Matt-Santos/PWM-Motor-Driver/documents/README.md

This project focuses on designing and evaluating a brushless motor control circuit that implements both Sinusoidal Pulse Width Modulation (SPWM) and Trapezoidal Pulse Width Modulation (TPWM) techniques, without the use of positional feedback. The circuit integrates several subcircuits, including a Wien Bridge Oscillator, Triangle Wave Generator, Three Phase Generator, Comparator, Modulation/Inversion Circuit, and H-Bridge Driver. During testing, issues such as Wien Bridge instability, phase shift deviations, and back-emf voltage from motor rotation were observed. Despite these challenges, both SPWM and TPWM successfully actuated the motor within a 5Hz to 95Hz frequency range, with SPWM providing smoother performance compared to the more erratic TPWM.
