Matt-Santos/PWM-Motor-Driver/documents/images/Circuit Pictures/20160403_171216.jpg

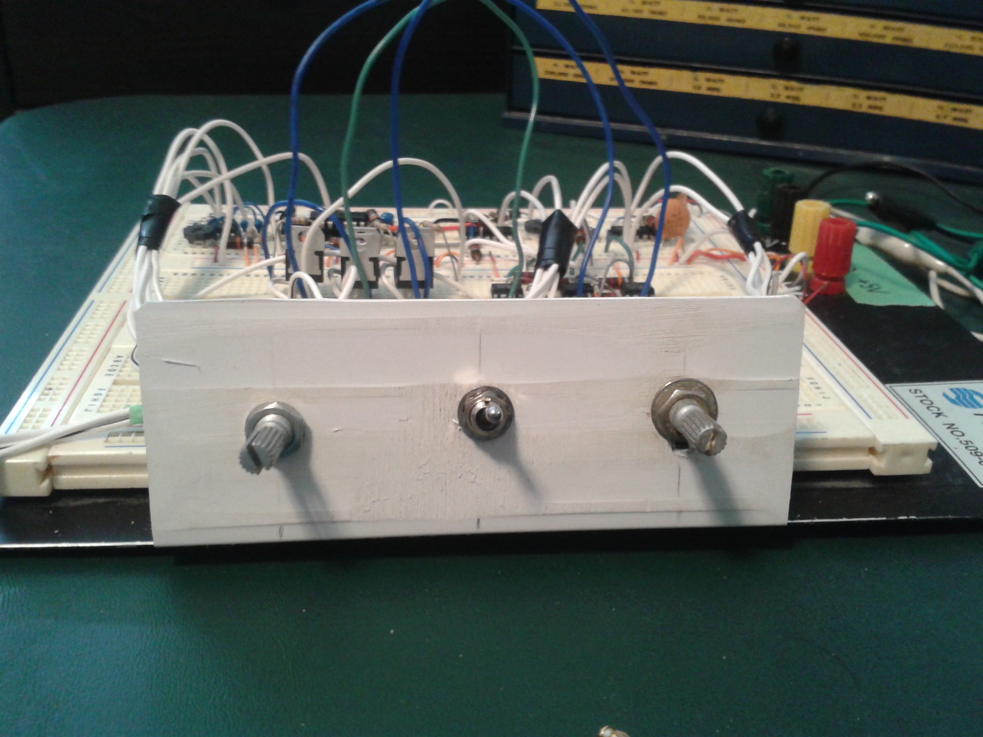
documents/images/Circuit Pictures/20160403_171216.jpg
