Matt-Santos/PWM-Motor-Driver/documents/images/Circuit Pictures/Final Budget.png

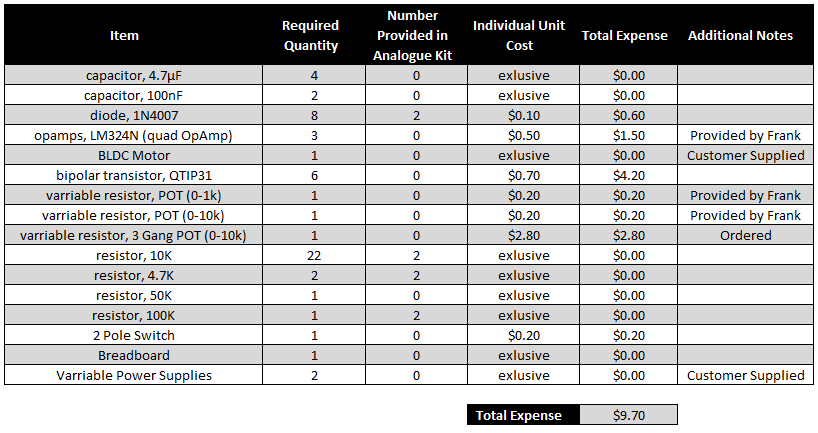
documents/images/Circuit Pictures/Final Budget.png
