Matt-Santos/PWM-Motor-Driver/documents/images/Circuit Pictures/Wien Bridge Oscillator.png

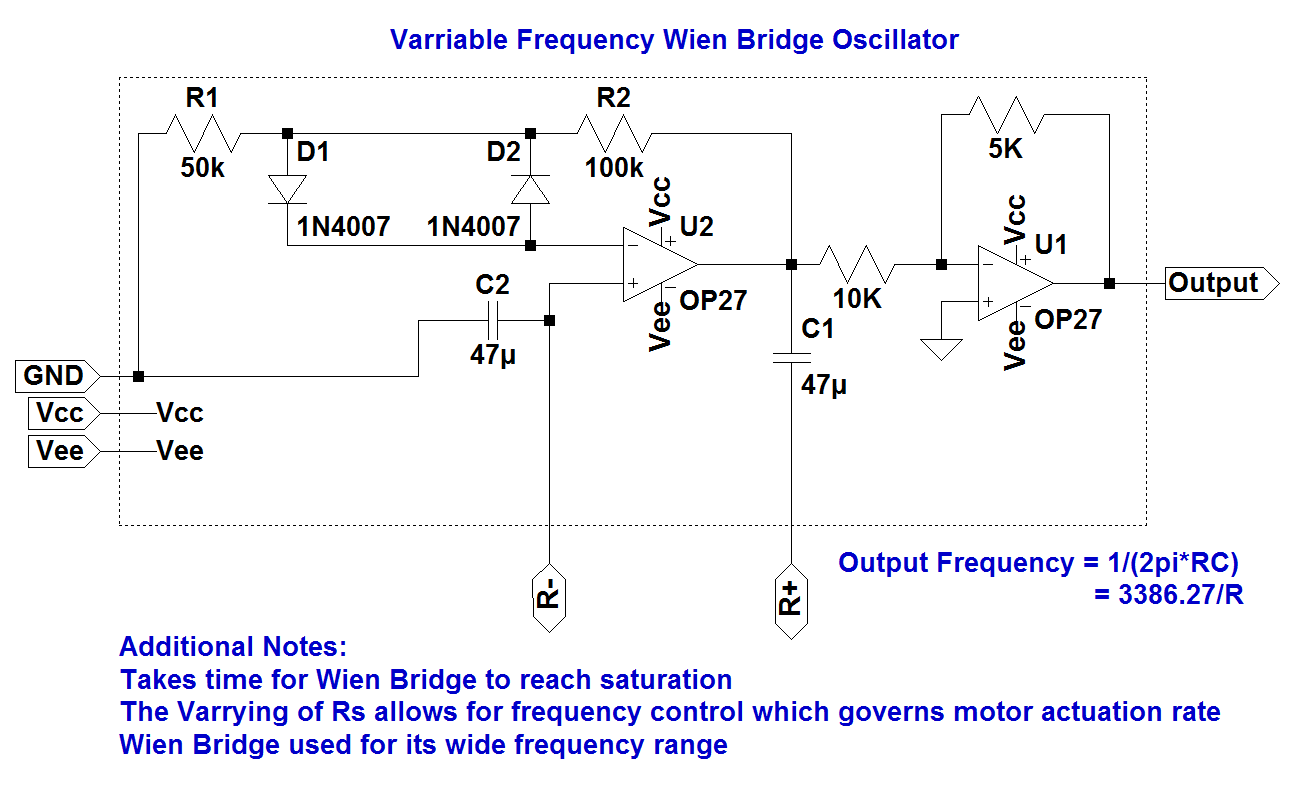
documents/images/Circuit Pictures/Wien Bridge Oscillator.png
