Matt-Santos/PWM-Motor-Driver/documents/images/Data Analysis/SPWM_Inversion.png

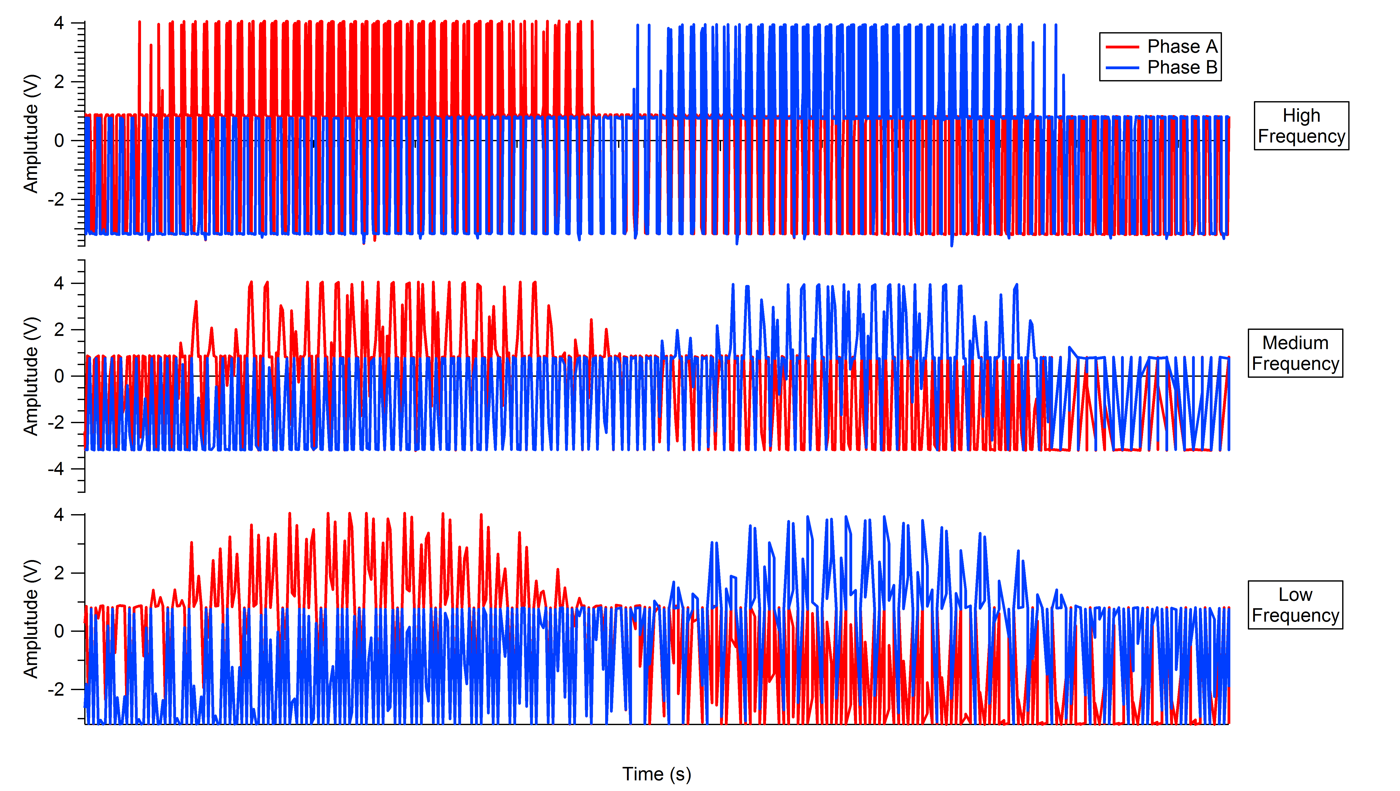
documents/images/Data Analysis/SPWM_Inversion.png
