Matt-Santos/PWM-Motor-Driver/documents/images/gallery/DC_Block_Diagram.jpg

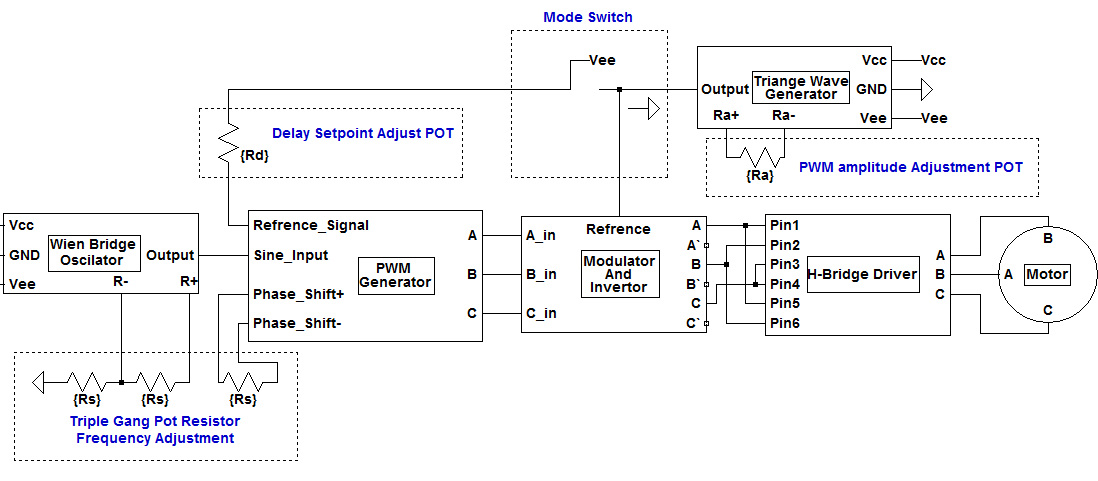
documents/images/gallery/DC_Block_Diagram.jpg
