Matt-Santos/PWM-Motor-Driver/documents/images/gallery/Overall_Design.jpg

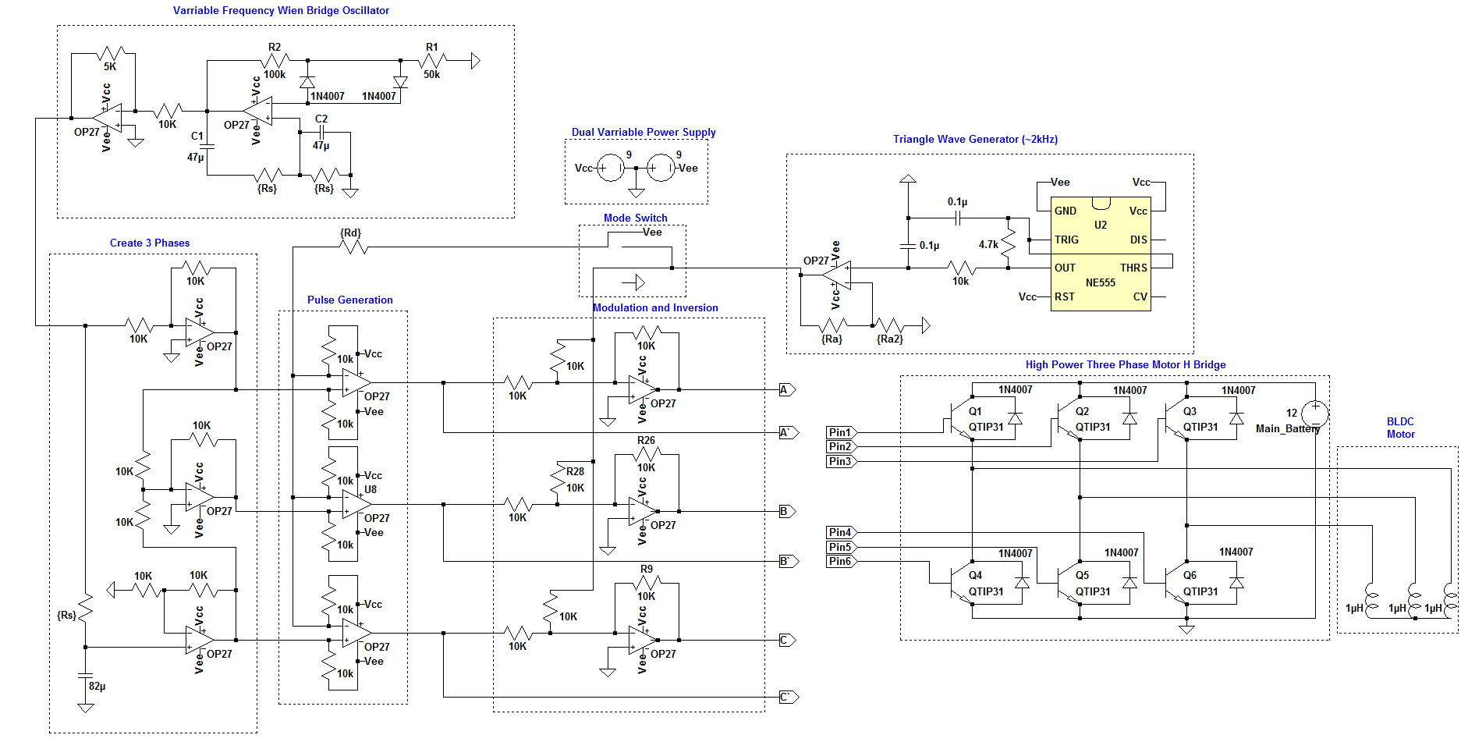
documents/images/gallery/Overall_Design.jpg
