Matt-Santos/PWM-Motor-Driver/documents/images/gallery/WBOFIXED.jpg

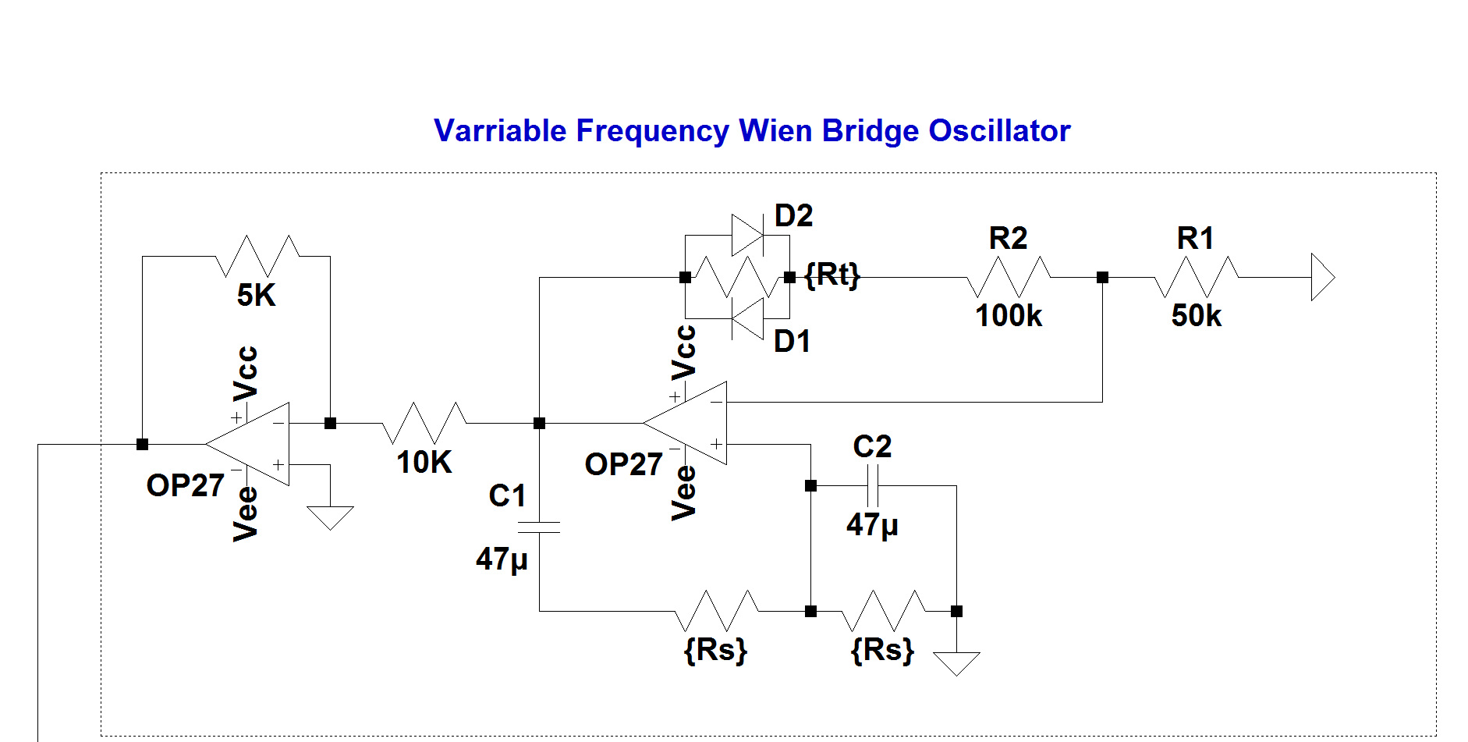
documents/images/gallery/WBOFIXED.jpg
