Matt-Santos/PWM-Motor-Driver/documents/images/project.jpg

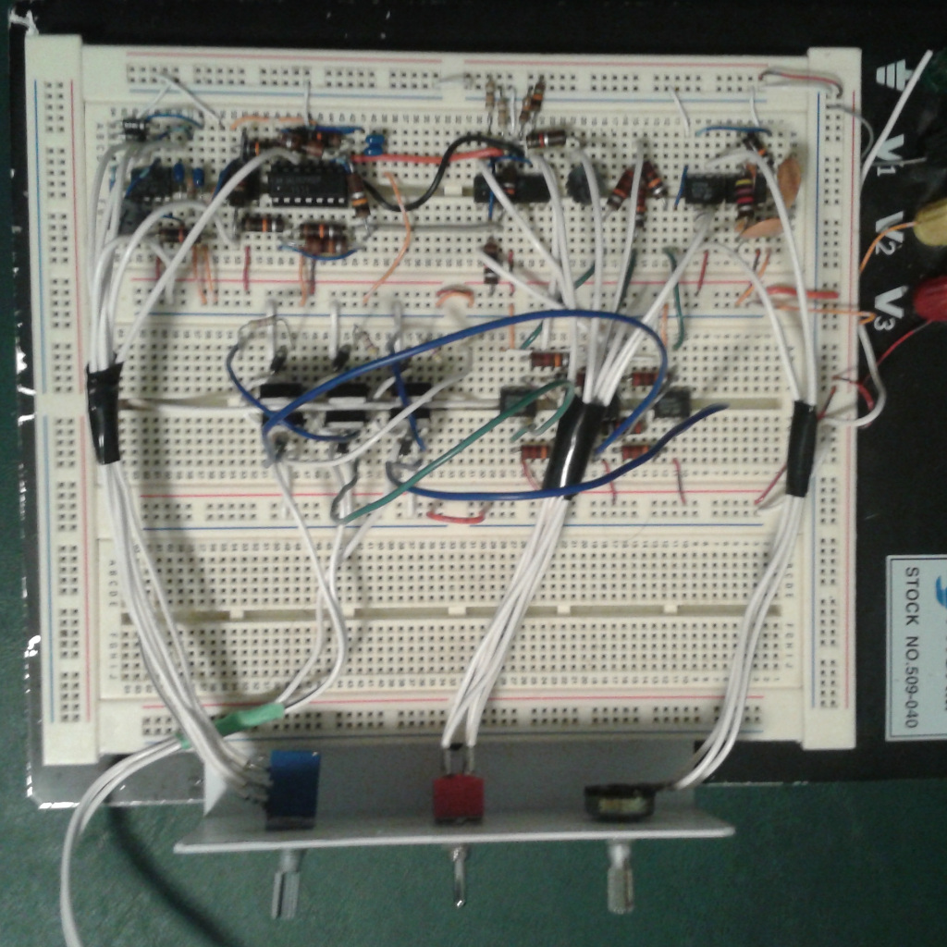
documents/images/project.jpg
