Matt-Santos/PWM-Motor-Driver/documents/Misc Data/h-bridge_thumb.png

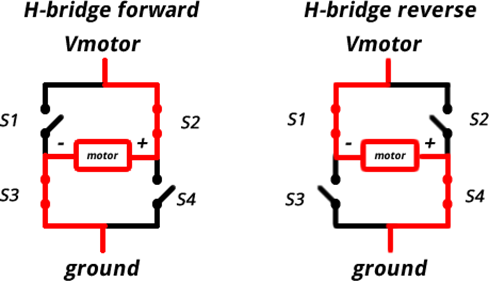
documents/Misc Data/h-bridge_thumb.png
