Matt-Santos/PWM-Motor-Driver/documents/Misc Data/PWM_Waveform2_Kurtis.png

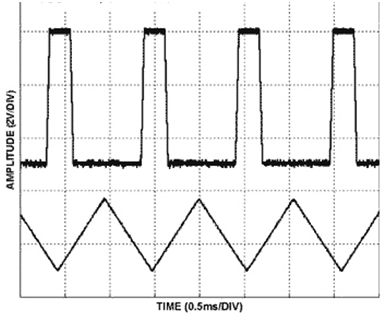
documents/Misc Data/PWM_Waveform2_Kurtis.png
