Matt-Santos/PWM-Motor-Driver/documents/Misc Data/PWM_Waveform3_Kurtis.png

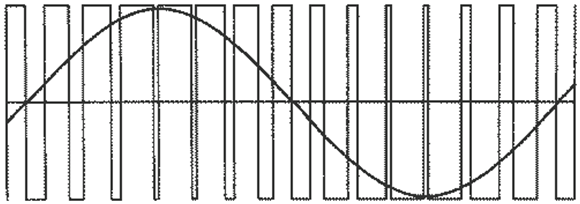
documents/Misc Data/PWM_Waveform3_Kurtis.png
