Matt-Santos/PWM-Motor-Driver/documents/Misc Data/Two Phase Motor States.jpg

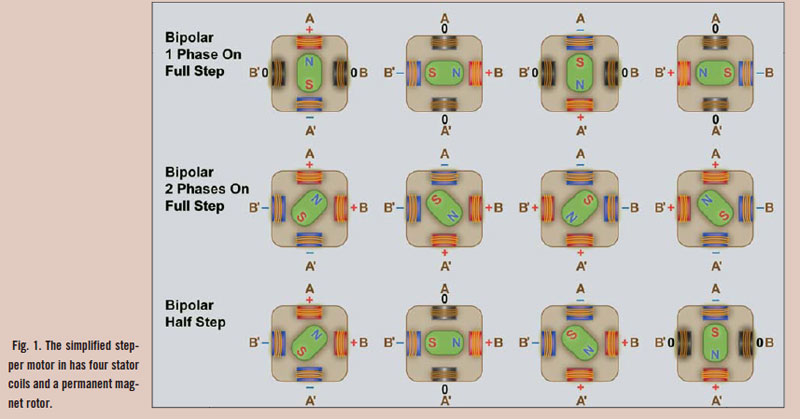
documents/Misc Data/Two Phase Motor States.jpg
