Matt-Santos/PWM-Motor-Driver/documents/Refrences/Design.bmp

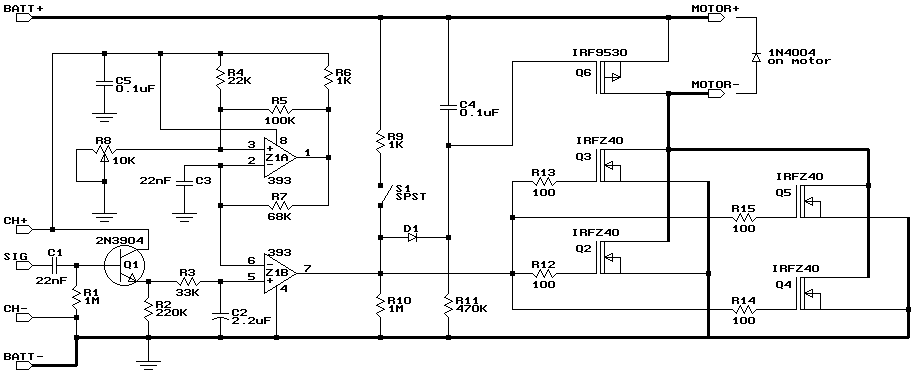
documents/Refrences/Design.bmp
