Matt-Santos/PWM-Motor-Driver/documents/Bill of Materials.xlsx

Sheet: Sheet1
Circuit Compatibility Check | Item | Quantity | Cost Per Unit | Total Cost | Number in Kit | Number in Stock | Location | Notes
 | 9V Battery | 2 | 1.31 | 2.62 | 0 | alot | somewhere
Good | NE555 | 1 | Free | 0 | 1 | 3 | Kurtus has
 | BLDC Motor | 1 | Free | 0 | 0 | 1 | my desk
Good | Breadboard | 1 | Free | 0 | 0 | 3 | shelf
 | 5-15V high current battery | 1 | Free | 0 | 0 | ?
 | 1N4007 Diode | 2 | Free | 0 | 2 | 2 | Analogue Kit
 | OP27 OpAmp | 2 | Free | 0 | 2 | 2 | Kit + Need
 | Power Transistors | 6 | ? |  | 0 | alot | shelf | alot of old ones on the shelf (15A)
 | 10k Resistors | 17 | 0.08 | 1.36
 | 100k | 2 | 0.08 | 0.16
 | 50k | 3 | 0.08 | 0.24
 | Varriable Resistors
 | Arguements |  |  |  |  |  | Total Cost | 4.38
 | Motor is application does not cost
 | Batteries not included (12V Driver)

Sheet: Sheet2
--- Bill of Materials --- |  |  | Overall Design
Ref. | Mfg. | Part No. | Description
R1 | -- | -- | resistor, 5.6K
R2 | -- | -- | resistor, 50K
R3 | -- | -- | resistor, 50K
R4 | -- | -- | resistor, 1K
R5 | -- | -- | resistor, 1K
--- Bill of Materials --- |  |  | Triangle Wave
Ref. | Mfg. | Part No. | Description
C1 | -- | -- | capacitor, 100nF
C2 | -- | -- | capacitor, 200nF
R1 | -- | -- | resistor, 100K
R2 | -- | -- | resistor, 10K
R3 | -- | -- | resistor, 50K
R4 | -- | -- | resistor, 10K
U1 | (unknown) | NE555 | (unknown 3rd party model)
U2 | (unknown) | OP27 | (unknown 3rd party model)
--- Bill of Materials --- |  |  | Wien Bridge
Ref. | Mfg. | Part No. | Description
C1 | -- | -- | capacitor, 47µF
C2 | -- | -- | capacitor, 47µF
D1 | -- | 1N4007 | diode
D2 | -- | 1N4007 | diode
R1 | -- | -- | resistor, 50K
R2 | -- | -- | resistor, 100K
U2 | (unknown) | OP27 | (unknown 3rd party model)
--- Bill of Materials --- |  |  | PWM Generator
Ref. | Mfg. | Part No. | Description
C2 | -- | -- | capacitor, 1µF
R1 | -- | -- | resistor, 10K
R2 | -- | -- | resistor, 10K
R3 | -- | -- | resistor, 10K
R4 | -- | -- | resistor, 10K
R5 | -- | -- | resistor, 10K
R6 | -- | -- | resistor, 10K
R7 | -- | -- | resistor, 10K
R10 | -- | -- | resistor, 10K
R11 | -- | -- | resistor, 10K
R12 | -- | -- | resistor, 10K
R22 | -- | -- | resistor, 10K
R23 | -- | -- | resistor, 10K
R26 | -- | -- | resistor, 10K
R28 | -- | -- | resistor, 10K
R29 | -- | -- | resistor, 10K
U1 | (unknown) | OP27 | (unknown 3rd party model)
U2 | (unknown) | OP27 | (unknown 3rd party model)
U3 | (unknown) | OP27 | (unknown 3rd party model)
U4 | (unknown) | OP27 | (unknown 3rd party model)
U8 | (unknown) | OP27 | (unknown 3rd party model)
U9 | (unknown) | OP27 | (unknown 3rd party model)
U10 | (unknown) | OP27 | (unknown 3rd party model)
--- Bill of Materials --- |  |  | Motor Driver
Ref. | Mfg. | Part No. | Description
M1 | -- | NMOS | MOSFET
M2 | -- | NMOS | MOSFET
M3 | -- | NMOS | MOSFET
M4 | -- | NMOS | MOSFET
M5 | -- | NMOS | MOSFET
M6 | -- | NMOS | MOSFET

Sheet: Kit Contents
Item | Quantity
4007 | 2
OP27GP | 2
1N4003 | 2
1N4733A | 2
2N3906 | 2
334-103 | 1
IR50 | 2
4.7R25 | 2
10R16 | 2
47R16 | 2
LED-5R | 2
91AR-20K | 1
ZVN2110A | 2
ZVP2110A | 2
R1/4-10 | 2
R1/4-100 | 2
R1/4-470 | 2
R1/4-1K | 2
R1/4-2.2K | 2
R1/4-4.7K | 2
R1/4-10K | 2
R1/4-22K | 2
R1/4-47K | 2
R1/4-100K | 2
R1/4-220K | 2
R1/4-1M | 2

Sheet: Sheet3
--- Bill of Materials ---
Ref. | Mfg. | Part No. | Description
C1 | -- | -- | capacitor, 47µF
C2 | -- | -- | capacitor, 47µF
C3 | -- | -- | capacitor, 100nF
C4 | -- | -- | capacitor, 100nF
C5 | -- | -- | capacitor, 82µF
D1 | -- | 1N4007 | diode
D2 | -- | 1N4007 | diode
D3 | -- | 1N4007 | diode
D4 | -- | 1N4007 | diode
D5 | -- | 1N4007 | diode
D6 | -- | 1N4007 | diode
D7 | -- | 1N4007 | diode
D8 | -- | 1N4007 | diode
Q1 | -- | QTIP31 | bipolar transistor
Q2 | -- | QTIP31 | bipolar transistor
Q3 | -- | QTIP31 | bipolar transistor
Q4 | -- | QTIP31 | bipolar transistor
Q5 | -- | QTIP31 | bipolar transistor
Q6 | -- | QTIP31 | bipolar transistor
R1 | -- | -- | resistor, 50K
R2 | -- | -- | resistor, 100K
R3 | -- | -- | resistor, 0 |  |  |  |  | corrected price
R4 | -- | -- | resistor, 0 | 1 3 gang pot |  | $2.50 |  | $2.50
R5 | -- | -- | resistor, 0 | 2 10k pots |  | $1.50 |  | $1.50
R6 | -- | -- | resistor, 0 | 6 QTIP31 transistors |  | $3.00 |  | $3.00
R7 | -- | -- | resistor, 10K | 8 1N4007 Diodes |  | $0.80 | 8@10c | $0.60
R8 | -- | -- | resistor, 4.7K | 12 Op27 | use quand LM324N | $1.50 | 3@50c | $1.50
R9 | -- | -- | resistor, 10K | 1 2 pole toggle switch |  | $0.20 |  | $0.20
R10 | -- | -- | resistor, 0 |  | total | $9.50 |  | $9.30
R11 | -- | -- | resistor, 10K
R12 | -- | -- | resistor, 10K
R13 | -- | -- | resistor, 10K
R14 | -- | -- | resistor, 10K
R15 | -- | -- | resistor, 10K
R16 | -- | -- | resistor, 10K
R17 | -- | -- | resistor, 10K
R18 | -- | -- | resistor, 10K
R19 | -- | -- | resistor, 10K
R20 | -- | -- | resistor, 10K
R21 | -- | -- | resistor, 10K
R22 | -- | -- | resistor, 10K
R23 | -- | -- | resistor, 10K
R24 | -- | -- | resistor, 10K
R25 | -- | -- | resistor, 5K
R26 | -- | -- | resistor, 10K
R27 | -- | -- | resistor, 10K
R28 | -- | -- | resistor, 10K
R29 | -- | -- | resistor, 10K
R30 | -- | -- | resistor, 10K
R31 | -- | -- | resistor, 10K
R32 | -- | -- | resistor, 10K
R33 | -- | -- | resistor, 10K
R34 | -- | -- | resistor, 10K
R35 | -- | -- | resistor, 10K
R36 | -- | -- | resistor, 10K
R37 | -- | -- | resistor, 10K
U1 | (unknown) | OP27 | (unknown 3rd party model)
U2 | (unknown) | NE555 | (unknown 3rd party model)
U3 | (unknown) | OP27 | (unknown 3rd party model)
U4 | (unknown) | OP27 | (unknown 3rd party model)
U5 | (unknown) | OP27 | (unknown 3rd party model)
U6 | (unknown) | OP27 | (unknown 3rd party model)
U7 | (unknown) | OP27 | (unknown 3rd party model)
U8 | (unknown) | OP27 | (unknown 3rd party model)
U9 | (unknown) | OP27 | (unknown 3rd party model)
U10 | (unknown) | OP27 | (unknown 3rd party model)
U11 | (unknown) | OP27 | (unknown 3rd party model)
U12 | (unknown) | OP27 | (unknown 3rd party model)
U13 | (unknown) | OP27 | (unknown 3rd party model)

Sheet: Sheet4
Ref. | Mfg. | Part No. | Description
C1 | -- | -- | capacitor, 47µF | Item | Required Quantity | Number Provided in Analogue Kit | Number in Inventory | Estimated Unit Cost | Total Expense | Additional Notes
C2 | -- | -- | capacitor, 47µF | capacitor, 47µF | 2 | 0 | 3 | exlusive | $0.00
C3 | -- | -- | capacitor, 100nF | capacitor, 100nF | 2 | 0 | 10 | exlusive | $0.00
C4 | -- | -- | capacitor, 100nF | capacitor, 82µF | 2 | 0 | 0 | exlusive | $0.00 | Need to Order
C5 | -- | -- | capacitor, 82µF | diode, 1N4007 | 8 | 2 | 100+ | $0.10 | $0.60
D1 | -- | 1N4007 | diode | opamps, LM324N (quad OpAmp) | 3 | 0 | unknown | $0.50 | $1.50 | alternatives exist
D2 | -- | 1N4007 | diode | BLDC Motor | 1 | 0 | 1 | exlusive | $0.00 | Customer Supplied
D3 | -- | 1N4007 | diode | bipolar transistor, QTIP31 | 6 | 0 | 40+ | $0.50 | $3.00
D4 | -- | 1N4007 | diode | varriable resistor, POT (0-10k) | 1 | 0 | 0 | $0.75 | $0.75 | Need to Order
D5 | -- | 1N4007 | diode | varriable resistor, POT (0-10k) | 1 | 0 | 0 | $0.75 | $0.75 | Need to Order
D6 | -- | 1N4007 | diode | varriable resistor, 3 Gang POT (0-10k) | 1 | 0 | 0 | $2.50 | $2.50 | Need to Order
D7 | -- | 1N4007 | diode | resistor, 10K | 22 | 2 | 30+ | exlusive | $0.00
D8 | -- | 1N4007 | diode | resistor, 4.7K | 2 | 2 | 30+ | exlusive | $0.00
L1 | -- | -- | inductor, 1µH, 800mA pk | resistor, 50K | 1 | 0 | 30+ | exlusive | $0.00
L2 | -- | -- | inductor, 1µH, 800mA pk | resistor, 100K | 1 | 2 | 30+ | exlusive | $0.00
L3 | -- | -- | inductor, 1µH, 800mA pk | 4 Pole Switch | 1 | 0 | 5 | $0.20 | $0.20
Q1 | -- | QTIP31 | bipolar transistor | Breadboard | 1 | 0 | 2 | exlusive | $0.00
Q2 | -- | QTIP31 | bipolar transistor | Varriable Power Supplies | 2 | 0 | 2 | exlusive | $0.00 | Customer Supplied
Q3 | -- | QTIP31 | bipolar transistor
Q4 | -- | QTIP31 | bipolar transistor |  |  |  | Total Estimated Expense |  | $9.30
Q5 | -- | QTIP31 | bipolar transistor
Q6 | -- | QTIP31 | bipolar transistor
R1 | -- | -- | resistor, 50K
R2 | -- | -- | resistor, 100K
R3 | -- | -- | resistor, 0
R4 | -- | -- | resistor, 0
R5 | -- | -- | resistor, 0
R6 | -- | -- | resistor, 0 |  |  |  |  |  | corrected price
R7 | -- | -- | resistor, 10K |  | 1 3 gang pot |  | $2.50 |  | $2.50
R8 | -- | -- | resistor, 4.7K |  | 2 10k pots |  | $1.50 |  | $1.50
R9 | -- | -- | resistor, 10K |  | 6 QTIP31 transistors |  | $3.00 |  | $3.00
R10 | -- | -- | resistor, 0 |  | 8 1N4007 Diodes |  | $0.80 | 8@10c | $0.60
R11 | -- | -- | resistor, 10K |  | 12 Op27 | use quand LM324N | $1.50 | 3@50c | $1.50
R12 | -- | -- | resistor, 10K |  | 1 2 pole toggle switch |  | $0.20 |  | $0.20
R13 | -- | -- | resistor, 10K |  |  | total | $9.50 |  | $9.30
R14 | -- | -- | resistor, 10K
R15 | -- | -- | resistor, 10K
R16 | -- | -- | resistor, 10K
R17 | -- | -- | resistor, 10K
R18 | -- | -- | resistor, 10K
R19 | -- | -- | resistor, 10K
R20 | -- | -- | resistor, 10K
R21 | -- | -- | resistor, 10K
R22 | -- | -- | resistor, 10K
R23 | -- | -- | resistor, 10K
R24 | -- | -- | resistor, 10K
R25 | -- | -- | resistor, 5K
R26 | -- | -- | resistor, 10K
R27 | -- | -- | resistor, 10K
R28 | -- | -- | resistor, 10K
R29 | -- | -- | resistor, 10K
R30 | -- | -- | resistor, 10K
R32 | -- | -- | resistor, 10K
R33 | -- | -- | resistor, 10K
R36 | -- | -- | resistor, 10K
R39 | -- | -- | resistor, 10K
U1 | (unknown) | OP27 | (unknown 3rd party model)
U2 | (unknown) | NE555 | (unknown 3rd party model)
U3 | (unknown) | OP27 | (unknown 3rd party model)
U4 | (unknown) | OP27 | (unknown 3rd party model)
U5 | (unknown) | OP27 | (unknown 3rd party model)
U6 | (unknown) | OP27 | (unknown 3rd party model)
U7 | (unknown) | OP27 | (unknown 3rd party model)
U8 | (unknown) | OP27 | (unknown 3rd party model)
U9 | (unknown) | OP27 | (unknown 3rd party model)
U10 | (unknown) | OP27 | (unknown 3rd party model)
U11 | (unknown) | OP27 | (unknown 3rd party model)
U12 | (unknown) | OP27 | (unknown 3rd party model)
U13 | (unknown) | OP27 | (unknown 3rd party model)
