Matt-Santos/PWM-Motor-Driver/hardware/Experimental Data/Data.xlsx

Sheet: WienBridgeOscilator
R_setpoint(kO) | R_setpoint_error | Foutput | Foutput_error | Voutput_(V) | Voutput_error
10.0 | 1 | 5.75 | 0.44 | 8.76 | 0.075
9.0 | 0.9 | 6.32 | 0.41 | 8.76 | 0.066
8.0 | 0.8 | 6.94 | 0.50 | 8.75 | 0.076
7.0 | 0.7 | 8.08 | 0.64 | 8.72 | 0.097
6.0 | 0.6 | 9.28 | 0.86 | 8.65 | 0.082
5.0 | 0.5 | 11.27 | 0.84 | 8.63 | 0.080
4.0 | 0.4 | 14.00 | 1.01 | 8.55 | 0.074
3.0 | 0.3 | 19.05 | 1.65 | 8.41 | 0.050
2.0 | 0.2 | 27.91 | 2.70 | 8.18 | 0.075
1.0 | 0.1 | 62.40 | 3.03 | 7.55 | 0.071
0.8 | 0.08 | 98.15 | 4.22 | 6.91 | 0.091

Sheet: Phase_Generation
R_setpoint(kO) | R_setpoint_error | Foutput | Foutput_error | Vpp_A | Vpp_A_error | Vpp_B | Vpp_B_error | Vpp_C | Vpp_C_error | Phase_AB | Phase_AB_error | Phase_BC | Phase_BC_error | RelPhaseAB | RelPhaseBC
10.0 | 1 | 5.75 | 0.44 | 3.83 | 4 | 3.92 | 4 | 4.07 | 10 | -132.7 | 2 | 120.2 | 0.4 | -12.7 | 0.2
9.0 | 0.9 | 6.32 | 0.41 | 3.82 | 5 | 3.93 | 4 | 4.1 | 10 | -131.4 | 0.9 | 119.6 | 0.7 | -11.4 | -0.4
8.0 | 0.8 | 6.94 | 0.50 | 3.83 | 5 | 3.93 | 7 | 4.09 | 10 | -130.6 | 0.9 | 120.1 | 0.2 | -10.6 | 0.1
7.0 | 0.7 | 8.08 | 0.64 | 3.83 | 5 | 3.91 | 5 | 4.07 | 30 | -130.4 | 0.9 | 120.5 | 0.9 | -10.4 | 0.5
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
