Matt-Santos/PWM-Motor-Driver/hardware/Experimental Data/raw data/data.xlsx

Rsetpoint | Kl | VA | Vpp | Vb | Vpp | Vc | Vpp | Phase AB | 0 | Phase BC
10.0 | 10% | 3.83 | 4 | 3.92 | 4 | 4.07 | 10 | -132.7 | 2 | 120.2 | 0.4
9.0 | 10% | 3.82 | 5 | 3.93 | 4 | 4.1 | 10 | -131.4 | 0.9 | 119.6 | 0.7
8.0 | 10% | 3.83 | 5 | 3.93 | 7 | 4.09 | 10 | -130.6 | 0.9 | 120.1 | 0.2
7.0 | 10% | 3.83 | 5 | 3.91 | 5 | 4.07 | 30 | -130.4 | 0.9 | 120.5 | 0.9
6.0 | 10% | 3.81 | 4 | 3.87 | 4 | 4.06 | 11 | -131.2 | 0.9 | 121.5 | 0.8
5.0 | 10% | 3.82 | 2 | 3.91 | 3 | 4.09 | 11 | -131.1 | 1.2 | 122.7 | 0.8
4.0 | 10% | 3.88 | 2 | 3.95 | 1 | 4.14 | 8 | -129.9 | 1.6 | 121.6 | 1.1
3.0 | 10% | 3.80 | 3 | 3.79 | 3 | 4.11 | 13 | -129.3 | 1.7 | 121.7 | 1.6
2.0 | 10% | 3.76 | 2 | 3.73 | 3 | 3.99 | 10 | -127.6 | 2.2 | 123.9 | 1.7
1.0 | 10% | 3.57 | 3 | 3.55 | 6 | 3.54 | 15 | -128.2 | 7.6 | 125.8 | 4.8
0.8 | 10% | 3.55 | 5 | 3.41 | 4 | 3.42 | 15 | -129.3 | 4.0 | 125.0 | 7.9
<0.7 |  | 0 |  | 0 |  | 0
Foutput | HZ | Rsetpoint | Hz | Voutput | Vpp
5.75 | 0.44 | 10.0 | 10% | 8.76 | 0.075
6.32 | 0.41 | 9.0 | 10% | 8.76 | 0.066
6.94 | 0.50 | 8.0 | 10% | 8.75 | 0.076
8.08 | 0.64 | 7.0 | 10% | 8.72 | 0.097
9.28 | 0.86 | 6.0 | 10% | 8.65 | 0.082
11.27 | 0.84 | 5.0 | 10% | 8.63 | 0.080
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
