Matt-Santos/PWM-Motor-Driver/hardware/Experimental Data/raw data/inversion_spwm_low.csv

x-axis | 1 | 2
second | Volt | Volt
-471.2000E-03 | -974.7173E-03 | +2.4571294E+00
-470.7000E-03 | -1.6452575E+00 | +2.6703831E+00
-470.2000E-03 | +847.2048E-03 | +775.9108E-03
-469.7000E-03 | -3.1587625E+00 | -858.1972E-03
-469.2000E-03 | +810.1445E-03 | +753.9259E-03
-468.7000E-03 | -3.1719535E+00 | -2.1757223E+00
-468.2000E-03 | +809.2023E-03 | +749.8430E-03
-467.7000E-03 | -3.1807475E+00 | +3.8764133E+00
-467.2000E-03 | +845.3203E-03 | +776.8530E-03
-466.7000E-03 | +327.7324E-03 | +1.2774811E+00
-466.2000E-03 | -3.0070666E+00 | +3.7357098E+00
-465.7000E-03 | +813.9133E-03 | +751.7274E-03
-465.2000E-03 | -3.1760364E+00 | -2.6744661E+00
-464.7000E-03 | +809.2023E-03 | +748.9007E-03
-464.2000E-03 | -3.1788630E+00 | +2.7115264E+00
-463.7000E-03 | +809.2023E-03 | +748.9007E-03
-463.2000E-03 | -2.5054962E+00 | +3.6392902E+00
-462.7000E-03 | -2.3428078E+00 | +3.2614635E+00
-462.2000E-03 | +789.1018E-03 | +850.3455E-03
-461.7000E-03 | -3.1587625E+00 | -22.1420E-03
-461.2000E-03 | +810.1445E-03 | +748.9007E-03
-460.7000E-03 | -3.1719535E+00 | -1.7828203E+00
-460.2000E-03 | +809.2023E-03 | +748.9007E-03
-459.7000E-03 | -3.1807475E+00 | +3.9147299E+00
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
