Matt-Santos/PWM-Motor-Driver/hardware/Experimental Data/raw data/motor_spwm_current.csv

x-axis | 1 | 2
second | Volt | Volt
-250.0000E-03 | -7.5220E-03 | -11.0245E-03
-249.7500E-03 | +82.4278E-03 | +169.3775E-03
-249.5000E-03 | +18.1062E-03 | +111.5886E-03
-249.2500E-03 | -7.0195E-03 | -9.5170E-03
-249.0000E-03 | +82.9303E-03 | +166.8649E-03
-248.7500E-03 | -180.3863E-03 | -80.3712E-03
-248.5000E-03 | -7.5220E-03 | -11.5270E-03
-248.2500E-03 | +80.9202E-03 | +164.3524E-03
-248.0000E-03 | -75.3612E-03 | -285.3964E-03
-247.7500E-03 | -8.0245E-03 | -11.5270E-03
-247.5000E-03 | +79.4127E-03 | +162.3423E-03
-247.2500E-03 | -72.8486E-03 | -294.4416E-03
-247.0000E-03 | -7.5220E-03 | -12.0295E-03
-246.7500E-03 | +78.9102E-03 | +160.8348E-03
-246.5000E-03 | -140.6878E-03 | -248.7129E-03
-246.2500E-03 | -8.0245E-03 | -11.5270E-03
-246.0000E-03 | +77.9051E-03 | +158.8247E-03
-245.7500E-03 | -224.6074E-03 | -283.8888E-03
-245.5000E-03 | -8.5270E-03 | -12.0295E-03
-245.2500E-03 | +78.4077E-03 | +158.3222E-03
-245.0000E-03 | -148.2255E-03 | -141.6778E-03
-244.7500E-03 | -9.5320E-03 | -12.5320E-03
-244.5000E-03 | +79.4127E-03 | +151.7896E-03
-244.2500E-03 | -20.0848E-03 | -23.0848E-03
-244.0000E-03 | -8.5270E-03 | -12.5320E-03
-243.7500E-03 | +121.1212E-03 | -974.2E-06
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
