Matt-Santos/PWM-Motor-Driver/hardware/Experimental Data/raw data/motor_tpwm_current.csv

x-axis | 1 | 2
second | Volt | Volt
-221.2000E-03
-220.9500E-03 | -8.9243E-03 | -19.1944E-03
-220.7000E-03 | -8.9432E-03 | -19.2258E-03
-220.4500E-03 | -8.9432E-03 | -19.2258E-03
-220.2000E-03 | -8.9432E-03 | -19.1944E-03
-219.9500E-03 | -8.9432E-03 | -19.2164E-03
-219.7000E-03 | -8.9934E-03 | -19.2447E-03
-219.4500E-03 | -8.9432E-03 | -19.1944E-03
-219.2000E-03 | -8.9432E-03 | -19.1944E-03
-218.9500E-03 | -8.9432E-03 | -19.1944E-03
-218.7000E-03 | -8.9432E-03 | -19.2258E-03
-218.4500E-03 | -8.9432E-03 | -19.2258E-03
-218.2000E-03 | -8.9055E-03 | -19.1661E-03
-217.9500E-03 | -8.9432E-03 | -19.2447E-03
-217.7000E-03 | -8.9432E-03 | -19.2258E-03
-217.4500E-03 | -8.9432E-03 | -19.2447E-03
-217.2000E-03 | -8.9432E-03 | -19.2447E-03
-216.9500E-03 | -8.9432E-03 | -19.2447E-03
-216.7000E-03 | -8.9432E-03 | -19.1944E-03
-216.4500E-03 | -9.4865E-03 | -19.9890E-03
-216.2000E-03 | -8.9432E-03 | -19.2447E-03
-215.9500E-03 | -8.9432E-03 | -19.1944E-03
-215.7000E-03 | -8.9432E-03 | -19.1944E-03
-215.4500E-03 | -8.9432E-03 | -19.2164E-03
-215.2000E-03 | -8.9432E-03 | -19.2164E-03
-214.9500E-03 | -8.9432E-03 | -19.2447E-03
-214.7000E-03 | -9.5682E-03 | -20.0707E-03
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
