Matt-Santos/PWM-Motor-Driver/hardware/Experimental Data/raw data/wbo_out_10kohm.png

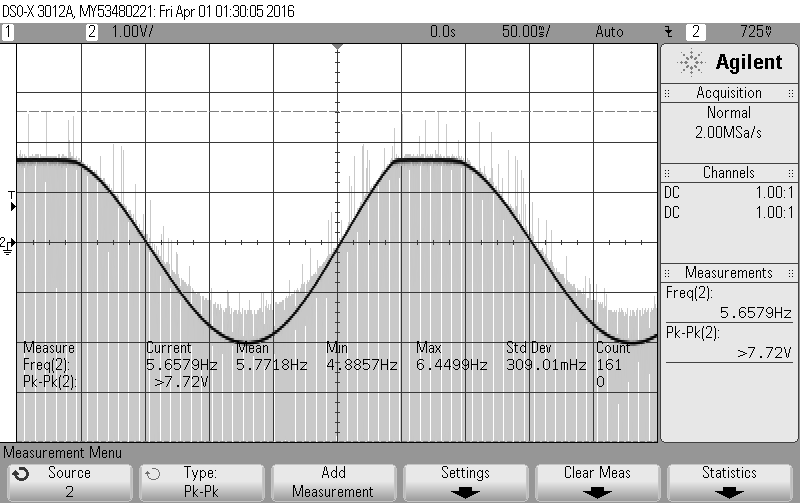
hardware/Experimental Data/raw data/wbo_out_10kohm.png
