Matt-Santos/PWM-Motor-Driver/hardware/Simulations/Complete_Design(AC).asc

C1: cap; 47µ
C2: cap; 47µ
C3: cap; 0.1µ
C4: cap; 0.1µ
C5: cap; 82µ
D1: diode; 1N4007
D2: diode; 1N4007
D3: diode; 1N4007
D4: diode; 1N4007
D5: diode; 1N4007
D6: diode; 1N4007
D7: diode; 1N4007
D8: diode; 1N4007
L1: ind; 1µH; Ipk=0.8 Rser=0.01
L2: ind; 1µH; Ipk=0.8 Rser=0.01
L3: ind; 1µH; Ipk=0.8 Rser=0.01
Main_Battery: voltage; 12
Q1: npn; QTIP31
Q2: npn; QTIP31
Q3: npn; QTIP31
Q4: npn; QTIP31
Q5: npn; QTIP31
Q6: npn; QTIP31
R1: res; 50k
R2: res; 100k
R3: res; {Rs}
R4: res; {Rs}
R5: res; {Rs}
R6: res; {Rd}
R7: res; 10k
R8: res; 4.7k
R9: res; 10K
R10: res; {Ra}
R11: res; 10K
R12: res; 10K
R13: res; 10K
R14: res; 10K
R15: res; 10K
R16: res; 10k
R17: res; 10k
R18: res; 10k
R19: res; 10k
R20: res; 10k
R21: res; 10k
R22: res; 10K
R23: res; 10K
R24: res; 10K
R25: res; 5K
R26: res; 10K
R27: res; 10K
R28: res; 10K
R29: res; 10K
R30: res; 10K
R32: res; 10K
R33: res; 10K
R36: res; 10K
R39: res; 10K
U1: OP27
U2: NE555
U3: OP27
U4: OP27
U5: OP27
U6: OP27
U7: OP27
U8: OP27
U9: OP27
U10: OP27
U11: OP27
U12: OP27
U13: OP27
V1: voltage; 9
V2: voltage; 9
Named nets: Vee, Vcc, 0, A, A`, B, B`, C, C`, Pin1, Pin2, Pin3, Pin4, Pin5, Pin6
.tran 0 30s 0 startup uic
Varriable Frequency Wien Bridge Oscillator
Triangle Wave Generator (~2kHz)
Create 3 Phases
Pulse Generation
High Power Three Phase Motor H Bridge
.param Rs 2000
.MODEL Qtip31 npn
+IS=1e-09 BF=3656.16 NF=1.23899 VAF=10
+IKF=0.0333653 ISE=1e-08 NE=2.29374 BR=0.1
+NR=1.5 VAR=100 IKR=0.333653 ISC=1e-08
+NC=1.75728 RB=6.15083 IRB=100 RBM=0.00113049
+RE=0.0001 RC=0.0491489 XTB=50 XTI=1
+EG=1.05 CJE=3.26475e-10 VJE=0.446174 MJE=0.464221
+TF=2.06218e-09 XTF=15.0842 VTF=25.7317 ITF=0.001
+CJC=3.07593e-10 VJC=0.775484 MJC=0.476498 XCJC=0.750493
+FC=0.796407 CJS=0 VJS=0.75 MJS=0.5
+TR=9.57121e-06 PTF=0 KF=0 AF=1
BLDC
Motor
.param Rd 1500
Speed
Delay
Strength
Modulation
.param Ra 50k
.ic v(n006)=-1 v(n005)=1
Dual Varriable Power Supply
=> Speeds up simulation
Mode Switch
