Matt-Santos/PWM-Motor-Driver/hardware/Simulations/Complete_Design_Block_Diagram(AC).asc

R1: res; {Ra}
R2: res; {Rs}
R3: res; {Rs}
R4: res; {Rs}
R5: res; {Rd}
V1: voltage; 9
V2: voltage; 9
X1: Wien_Bridge_Oscilator
X2: Triangle_Wave_Generator
X3: H_Bridge_Driver
X4: PWM_Generator
X5: Simple_Motor
X6: Modulation_and_Inversion
Named nets: 0, Vcc, Vee
Triple Gang Pot Resistor
Frequency Adjustment
Delay Setpoint Adjust POT
PWM amplitude Adjustment POT
Mode Switch
(AC State)
AC Motor SPWM Configuration
.tran 0 10 0 startup
