Matt-Santos/PWM-Motor-Driver/hardware/Simulations/H_Bridge_Driver.asc

D1: diode; 1N4007
D2: diode; 1N4007
D3: diode; 1N4007
D4: diode; 1N4007
D5: diode; 1N4007
D6: diode; 1N4007
Main_Battery: voltage; 12
Q1: npn; QTIP31
Q2: npn; QTIP31
Q3: npn; QTIP31
Q4: npn; QTIP31
Q5: npn; QTIP31
Q6: npn; QTIP31
Named nets: 0, Pin1, Pin2, Pin3, Pin4, Pin5, Pin6, A, B, C
High Power Three Phase Motor H Bridge
Additional Notes:
Diodes protect the transistors from sudden voltage spikes arising from the motor switching
Time delay between switching prevents the shorting of the Main Power Supply
Design Identical for both AC and DC however pin arrangement is varried
Selected components allow for a limit of 1A supply current (should be enough)
