Matt-Santos/PWM-Motor-Driver/hardware/Simulations/Modulation_and_Inversion.asc

R1: res; 10K
R2: res; 10K
R3: res; 10K
R4: res; 10K
R5: res; 10K
R6: res; 10K
R7: res; 10K
R8: res; 10K
R9: res; 10K
U1: OP27
U2: OP27
U3: OP27
Named nets: Vcc, Vee, 0, A, A`, B, B`, C, C`, A_in, B_in, C_in, Refrence
DC Modulation and AC Waveform Inversion
Additional Notes:
When in DC mode refrence is high frequency triangle wave approriately summed with the
phase input in order to achive a modulation effect on the outputs (A,B,C)
 
When in AC mode refrence is grounded and the system provides the needed A,B,C SPWM
waveforms and their associated inverses. (Note alot of planning went into this part)
