Matt-Santos/PWM-Motor-Driver/hardware/Simulations/PWM_Generator.asc

C2: cap; 82µ
R1: res; 10k
R2: res; 10k
R3: res; 10k
R4: res; 10k
R5: res; 10k
R6: res; 10k
R7: res; 10K
R10: res; 10K
R22: res; 10K
R23: res; 10K
R26: res; 10K
R28: res; 10K
R29: res; 10K
U1: OP27
U2: OP27
U3: OP27
U8: OP27
U9: OP27
U10: OP27
Named nets: 0, Vcc, Vee, A, B, C, Sine_Input, Phase_Shift+, Phase_Shift-, Refrence_Signal, GND
Resistor tuned based on desired input
frequency in order to obatin balanced phases
3 Phase Generation for DC Mode
Sine-Triangle Pulse Width Modulation for AC Mode
Calculations:
Needed 60 degrees or pi/6 shift
Theta = arctan(2pi*f*RC)
f*RC=0.27566
 
Coupling with Wien Bridge => select C=81.4uF
Then R=3361/f
