Matt-Santos/PWM-Motor-Driver/hardware/Simulations/Reality.asc

C1: cap; 47µ
C2: cap; 47µ
C6: cap; 47µ
C7: cap; 47µ
D1: diode; 1N4007
D2: diode; 1N4007
D9: diode; 1N4007
D10: diode; 1N4007
R1: res; 5k
R2: res; 9k
R3: res; {Rs}
R4: res; {Rs}
R5: res; 1k
R6: res; 5k
R7: res; 10k
R35: res; 5k
R36: res; 10k
R39: res; {Rs}
R40: res; {Rs}
U1: OP27
U2: OP27
U14: OP27
U15: OP27
V1: voltage; 9
V2: voltage; 9
Named nets: Vcc, 0, Vee
.tran 0 300s 0 startup uic
Varriable Frequency Wien Bridge Oscillator
.param Rs 2200
Speed
Delay
Strength
.ic v(n006)=-1 v(n005)=1
Dual Varriable Power Supply
=> Speeds up simulation
Varriable Frequency Wien Bridge Oscillator
Varriable Frequency Wien Bridge Oscillator
