Matt-Santos/PWM-Motor-Driver/hardware/Simulations/Simple_Motor.asc

L1: ind; 1µH; Ipk=0.8 Rser=0.01
L2: ind; 1µH; Ipk=0.8 Rser=0.01
L3: ind; 1µH; Ipk=0.8 Rser=0.01
Named nets: A, B, C
Motor
Simplistic Model does not account for varriations in resistance and 
the generation of back emf associated with the rotation of a real motor
 
Exists mainly for simulation test purposes
