Matt-Santos/PWM-Motor-Driver/hardware/Simulations/Triangle_Wave_Generator.asc

C1: cap; 0.1µ
C2: cap; 0.1µ
R1: res; 4.7k
R3: res; 10k
R10: res; 10K
U1: NE555
U5: OP27
Named nets: Vcc, Output, Vee, GND, 0, Ra+, Ra-
Additional Notes:
High Frequency = smoother AC operation (2kHz is sufficient)
Ground Refrence is skewed to remove DC bias (physically tested it works)
Ra is used to control the output magnitude (PWM output magnitude for both AC and DC)
Triangle Wave Generator (~2kHz)
