Matt-Santos/PWM-Motor-Driver/hardware/Simulations/Wien_Bridge_Oscilator.asc

C1: cap; 47µ
C2: cap; 47µ
D1: diode; 1N4007
D2: diode; 1N4007
R1: res; 50k
R2: res; 100k
R3: res; 10K
R4: res; 5K
U1: OP27
U2: OP27
Named nets: Vee, Vcc, Output, GND, R-, R+, 0
Varriable Frequency Wien Bridge Oscillator
Additional Notes:
Takes time for Wien Bridge to reach saturation
The Varrying of Rs allows for frequency control which governs motor actuation rate
Wien Bridge used for its wide frequency range
Output Frequency = 1/(2pi*RC)
                                = 3386.27/R
